PulsedLight3D/PulsedLight3dScanner/examples_and_assets/backdoor/backdoor.png

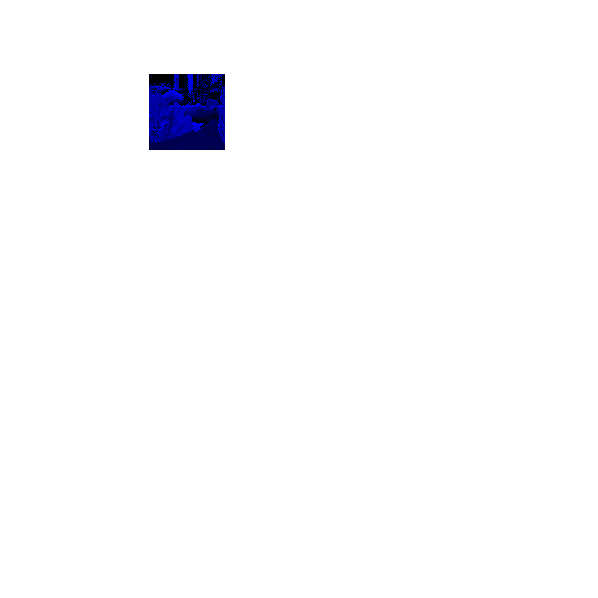
examples_and_assets/backdoor/backdoor.png
