PulsedLight3D/PulsedLight3dScanner/examples_and_assets/chair/chair_screenshot.png

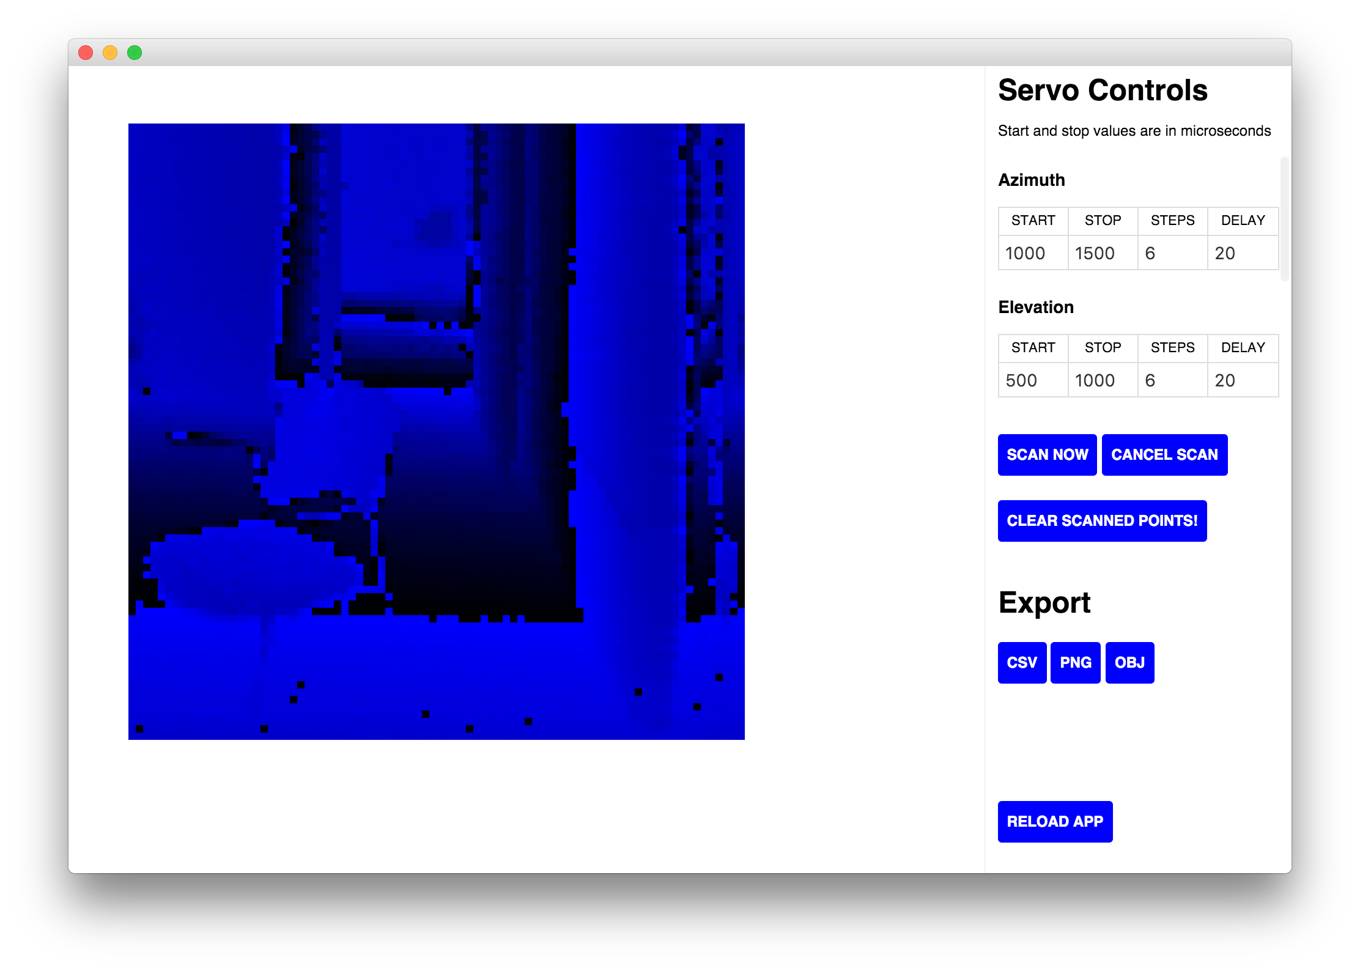
examples_and_assets/chair/chair_screenshot.png
