PulsedLight3D/PulsedLight3dScanner/examples_and_assets/readMeImg/scanner.jpg

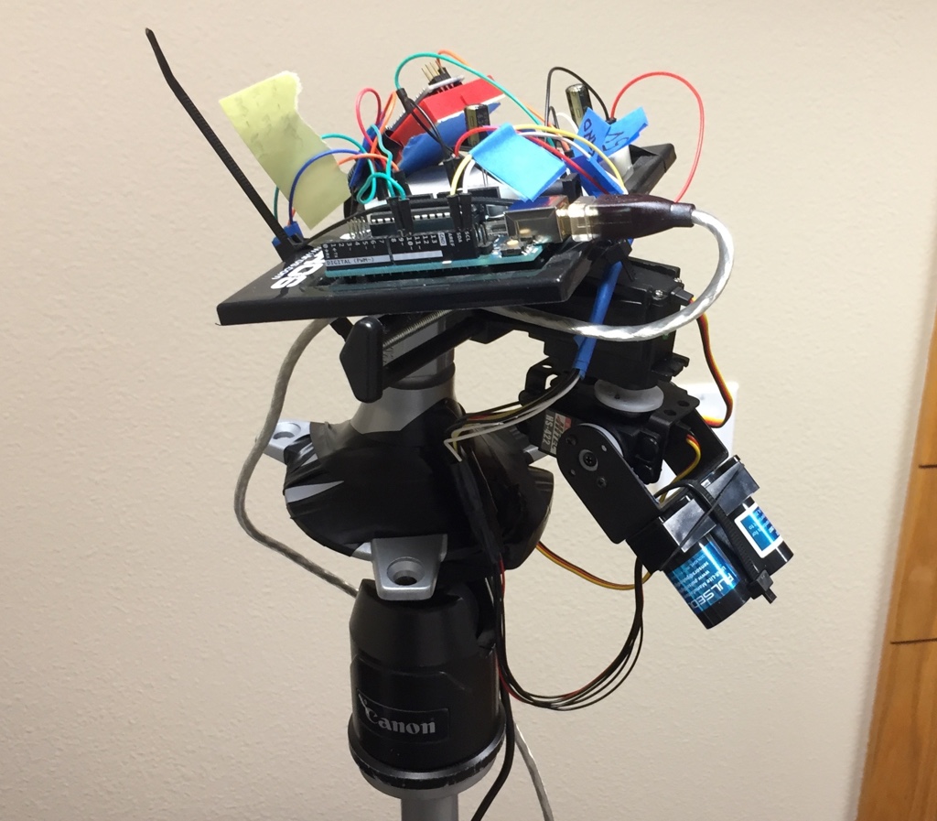
examples_and_assets/readMeImg/scanner.jpg
