PulsedLight3D/PulsedLight3dScanner/examples_and_assets/guitar/guitar_delay_test/png/guitar_03steps_05delay.png

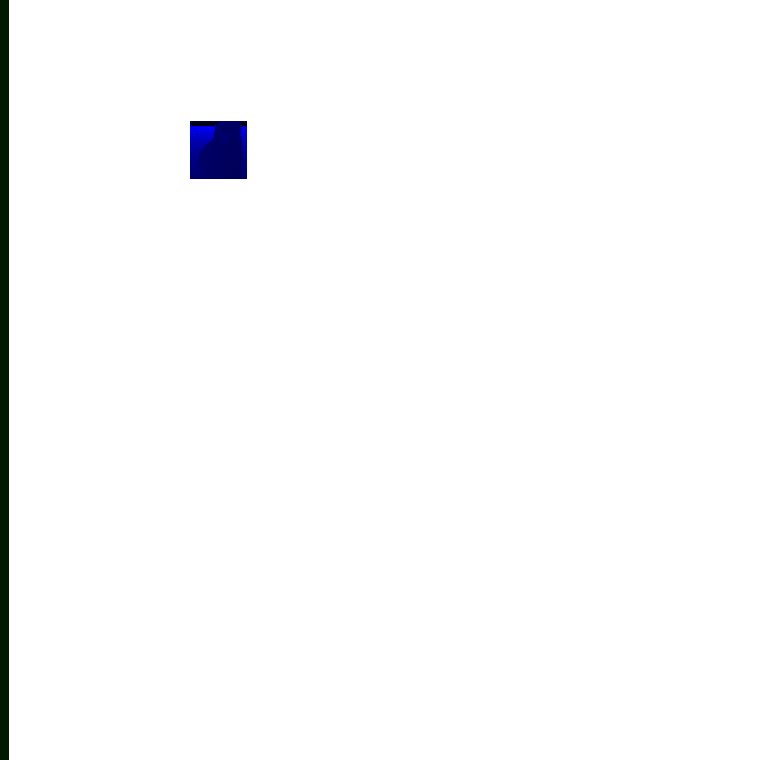
examples_and_assets/guitar/guitar_delay_test/png/guitar_03steps_05delay.png
