PulsedLight3D/PulsedLight3dScanner/(commit log)

2015-12-03 Update with samples
    [backdoor.csv, chair.csv]
2015-12-05 Add guitar example and experiments
    [backdoor.csv, chair.csv, guitar_01steps_20delay.csv, guitar_02steps_20delay.csv, guitar_03steps_00delay.csv, guitar_03steps_05delay.csv, guitar_03steps_10delay.csv, guitar_03steps_15delay.csv]
